donaldhbailie/reck-pcba/reck-pcba.pdf

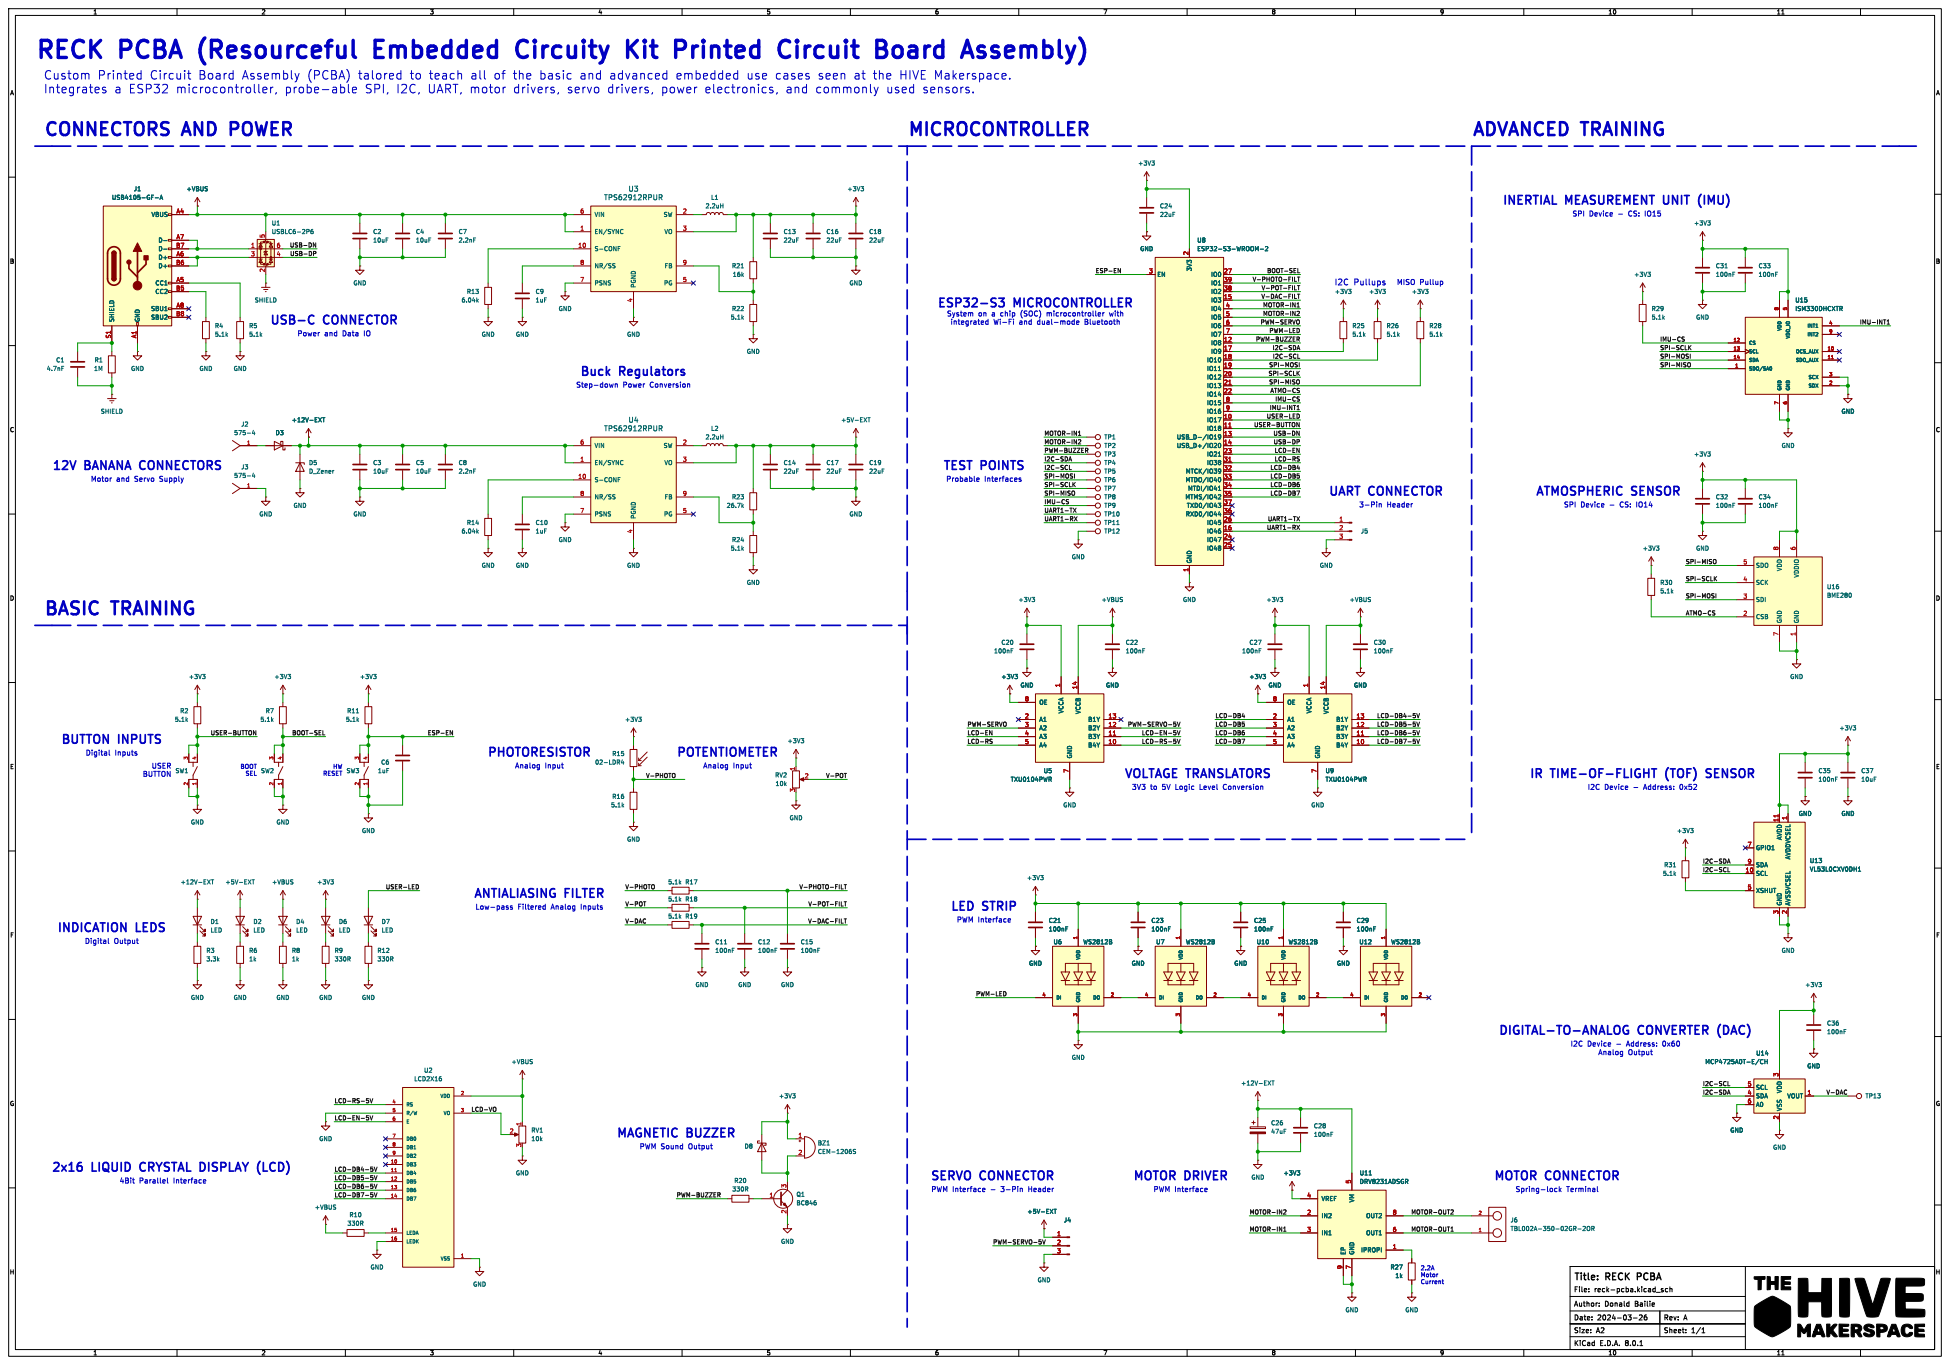
[picture p1: page 1]

Custom Printed Circuit Board Assembly (PCBA) talored to teach all of the basic and advanced embedded use cases seen at the HIVE Makerspace.
CONNECTORS AND POWER

4 VIN 6 EN/SYNC 1 S-CONF 10 SW 2 VO 3 PG 5 PSNS 7 NR/SS 8 FB 9 U3 TPS62912RPUR

INERTIAL MEASUREMENT UNIT (IMU)

MISO Pullup U8ESP32-S3-WROOM-2 GND

BOOT-SEL PWM-BUZZER
MOTOR-IN1 V-PHOTO-FILT PWM-SERVO
V-POT-FILT V-DAC-FILT PWM-LED

Power and Data IO

SPI-MOSI SPI-MISO
SPI-SCLK

4 VIN 6 EN/SYNC 1 S-CONF 10 SW 2 VO 3 PG 5 PSNS 7 NR/SS 8 FB 9 U4 TPS62912RPUR

I2C-SDA MOTOR-IN2 MOTOR-IN1 SPI-SCLK

Motor and Servo Supply

SPI-MISO
IMU-CS UART1-RX UART1-TX

7 OE 8 U5 TXU0104PWR GND GND GND

V-PHOTO
3V3 to 5V Logic Level Conversion PWM Sound Output

I2C Device - Address: 0x52 PWM Interface

3 DI 4 U6 WS2812B GND
PWM Interface SERVO CONNECTOR

I2C Device - Address: 0x60 DIGITAL-TO-ANALOG CONVERTER (DAC)

2x16 LIQUID CRYSTAL DISPLAY (LCD)
