donaldhbailie/reck-pcba/reck-pcba.kicad_pcb

## KiCad design reck-pcba.kicad_pcb (2024-08-18)

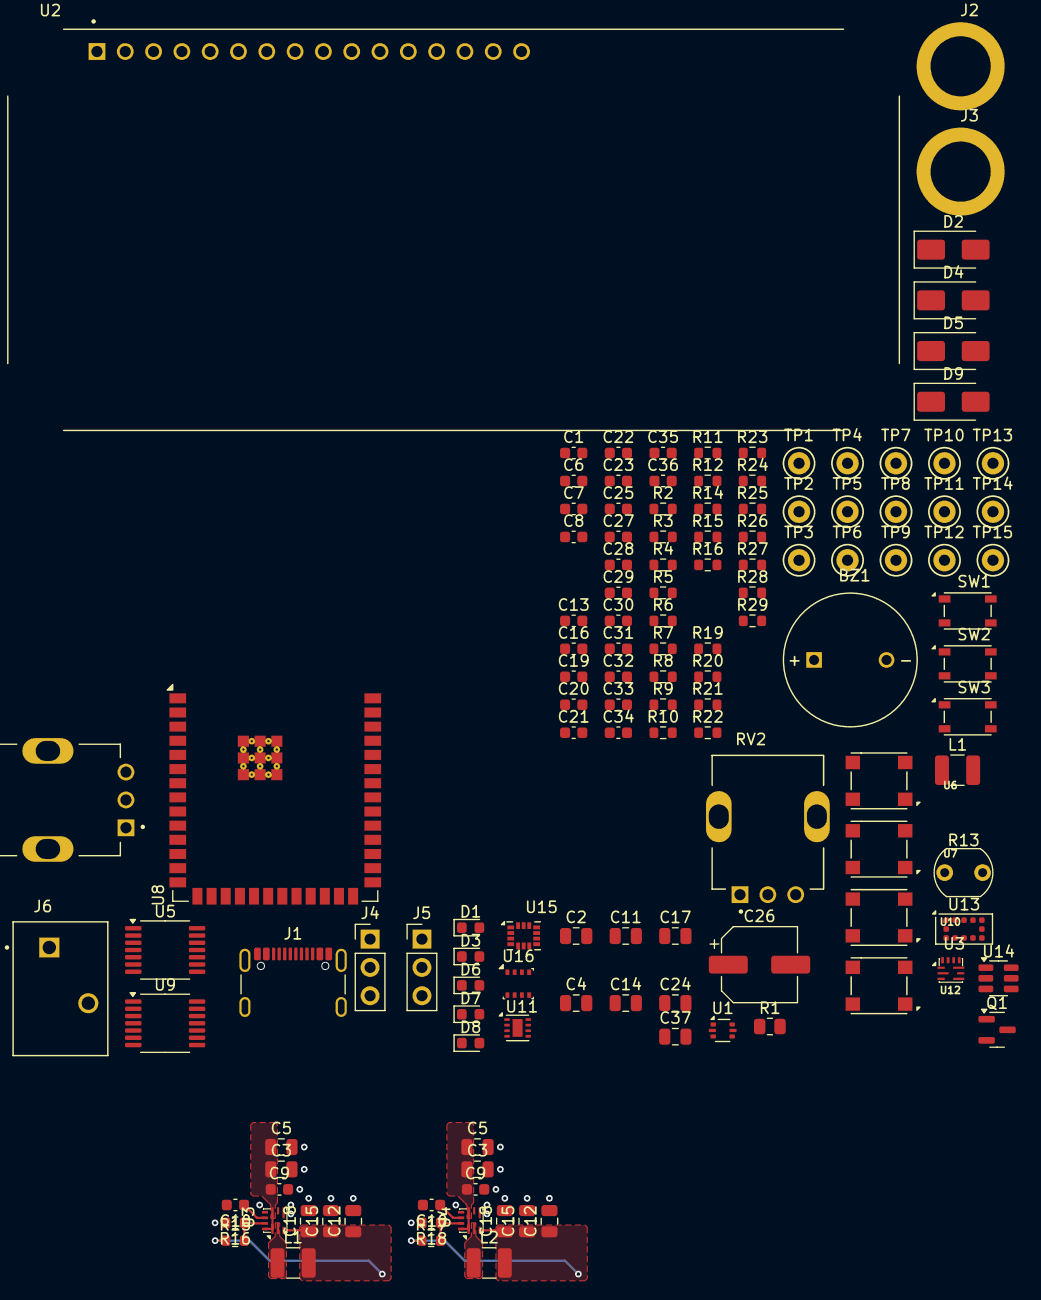
[picture p2: board reck-pcba.kicad_pcb from above]

Board: 4 copper layers, 132 parts (0 on the bottom side), 75 nets.

Parts:
BZ1: CEM-1206S
C1, C7, C9, C9#2: 2.2nF; C_0603_1608Metric
C2, C3, C3#2, C4, C5, C5#2, C37: 10uF; C_0805_2012Metric
C6, C8, C10, C10#2: 1uF; C_0603_1608Metric
C11, C12, C12#2, C14, C15, C15#2, C17, C18, C18#2, C24: 22uF; C_0805_2012Metric
C13, C16, C19, C20, C21, C22, C23, C25, C27, C28, C29, C30, C31, C32, C33, C34, C35, C36: 100nF; C_0603_1608Metric
C26: 47uF; CP_Elec_6.3x5.9
D1, D3, D6, D7, D8: LED; LED_0603_1608Metric
D2, D4, D9: CDBA340L-HF; D_SMA
D5: 1SMA5928BT3G; D_SMA
J1: USB4105-GF-A; USB_C_Receptacle_GCT_USB4105-xx-A_16P_TopMnt_Horizontal
J2, J3: 575-4
J4, J5: Conn_01x03_Pin; PinHeader_1x03_P2.54mm_Vertical
J6: TBL002A-350-02GR-2OR
L1, L1#2, L2: 2.2uH; L_1210_3225Metric
Q1: BC846; SOT-23
R1: 1M; R_0805_2012Metric
R2, R4, R5, R7, R11, R14, R16, R16#2, R18, R19, R20, R21, R23, R24, R26, R27, R28, R29: 5.1k; R_0603_1608Metric
R3, R25: 1k; R_0603_1608Metric
R6, R8: 330R; R_0603_1608Metric
R9, R10, R12, R22: 130R; R_0603_1608Metric
R13: 02-LDR4; R_LDR_5.1x4.3mm_P3.4mm_Vertical
R15: 16k; R_0603_1608Metric
R15#2, R17: 26.7k; R_0603_1608Metric
RV1, RV2: 10k; PT01-D130D-B103
SW1, SW2, SW3: PTS810_SJM_250_SMTR_LFS
TP1, TP2, TP3, TP4, TP5, TP6, TP7, TP8, TP9, TP10, TP11, TP12, TP13, TP14, TP15: TestPoint; TestPoint_Keystone_5000-5004_Miniature
U1: USBLC6-2P6; SOT-666
U2: LCD2X16
U3, U3#2, U4: TPS62912RPUR; VQFN-HR-10_2x2mm
U5, U9: TXU0104PWR; TSSOP-14_4.4x5mm_P0.65mm
U6, U7, U10, U12: WS2812B
U8: ESP32-S3-WROOM-2
U11: DRV8231ADSGR; WSON-8-1EP_2x2mm_P0.5mm_EP0.9x1.6mm
U13: VL53L0CXV0DH1; ST_VL53L1x
U14: MCP4725A0T-E/CH; SOT-23-6
U15: ISM330DHCXTR; LGA-14_2.5x3.0mm_P0.5mm
U16: BME280; Bosch_LGA-8_2.5x2.5mm_P0.65mm_ClockwisePinNumbering

Connections:
+3V3: BZ1.1, C11.1, C14.1, C17.1, C20.1, C21.1, C23.1, C24.1, C25.1, C27.1, C29.1, C31.1, C32.1, C33.1, C34.1, C35.1, C36.1, C37.1, D7.2 (A), D9.1 (K), L1.2, R2.1, R7.1, R11.1, R13.1, R15.1, R23.1, R24.1, R26.1, R27.1, R28.1, R29.1, RV2.1, U3#2.3 (VO), U5.1 (VCCA), U5.8 (OE), U6.1 (VDD), U7.1 (VDD), U8.2 (3V3), U9.1 (VCCA), U9.8 (OE), U10.1 (VDD), U11.4 (VREF), U12.1 (VDD), U13.1 (AVDDVCSEL), U13.11 (AVDD), U14.3 (VDD), U15.5 (VDD_IO), U15.8 (VDD), U16.6 (VDDIO), U16.8 (VDD)
+5V-EXT: C12.1, C12#2.1, C15.1, C15#2.1, C18.1, C18#2.1, D3.2 (A), J4.1, L1#2.2, L2.2, R15#2.1, R17.1, U3.3 (VO), U4.3 (VO)
+12V-EXT: C3.1, C3#2.1, C5.1, C5#2.1, C9.1, C9#2.1, C26.1, C28.1, D1.2 (A), D4.1 (K), D5.1 (K), U3.1 (EN/SYNC), U3.6 (VIN), U3.10 (S-CONF), U4.1 (EN/SYNC), U4.6 (VIN), U4.10 (S-CONF), U11.5 (VM)
+VBUS: C2.1, C4.1, C7.1, C22.1, C30.1, D2.1 (K), D6.2 (A), R10.1, RV1.1, U1.5 (VBUS), U2.2 (VDD), U3#2.1 (EN/SYNC), U3#2.6 (VIN), U3#2.10 (S-CONF), U5.14 (VCCB), U9.14 (VCCB)
+VBUS-CONN: D2.2 (A), J1.A4 (VBUS), J1.A9 (VBUS), J1.B4 (VBUS), J1.B9 (VBUS)
/ATMO-CS: R28.2, U8.22 (IO14), U16.2 (CSB)
/BOOT-SEL: R7.2, SW2.3, SW2.4, U8.27 (IO0)
/ESP-EN: C6.1, R11.2, SW3.3, SW3.4, U8.3 (EN)
/I2C-SCL: R24.2, TP5.1, U8.18 (IO10), U13.10 (SCL), U14.5 (SCL)
/I2C-SDA: R23.2, TP4.1, U8.17 (IO9), U13.9 (SDA), U14.4 (SDA)
/IMU-CS: R27.2, TP9.1, U8.8 (IO15), U15.12 (CS)
/IMU-INT1: U8.9 (IO16), U15.4 (INT1)
/LCD-DB4: U8.32 (MTCK/IO39), U9.2 (A1)
/LCD-DB4-5V: U2.11 (DB4), U9.13 (B1Y)
/LCD-DB5: U8.33 (MTDO/IO40), U9.3 (A2)
/LCD-DB5-5V: U2.12 (DB5), U9.12 (B2Y)
/LCD-DB6: U8.34 (MTDI/IO41), U9.4 (A3)
/LCD-DB6-5V: U2.13 (DB6), U9.11 (B3Y)
/LCD-DB7: U8.35 (MTMS/IO42), U9.5 (A4)
/LCD-DB7-5V: U2.14 (DB7), U9.10 (B4Y)
/LCD-EN: U5.4 (A3), U8.23 (IO21)
/LCD-EN-5V: U2.6 (E), U5.11 (B3Y)
/LCD-RS: U5.5 (A4), U8.31 (IO38)
/LCD-RS-5V: U2.4 (RS), U5.10 (B4Y)
/LCD-VO: RV1.2, U2.3 (VO)
/MOTOR-IN1: TP2.1, U8.4 (IO4), U11.3 (IN1)
/MOTOR-IN2: TP3.1, U8.5 (IO5), U11.2 (IN2)
/MOTOR-OUT1: J6.1, U11.6 (OUT1)
/MOTOR-OUT2: J6.2, U11.8 (OUT2)
/PWM-BUZZER: R22.1, U8.12 (IO8)
/PWM-LED: U6.4 (DI), U8.7 (IO7)
/PWM-SERVO: TP12.1, U5.3 (A2), U8.6 (IO6)
/PWM-SERVO-5V: J4.2, TP13.1, U5.12 (B2Y)
/SPI-MISO: R26.2, TP8.1, U8.21 (IO13), U15.1 (SDO/SA0), U16.5 (SDO)
/SPI-MOSI: TP6.1, U8.19 (IO11), U15.14 (SDA), U16.3 (SDI)
/SPI-SCLK: TP7.1, U8.20 (IO12), U15.13 (SCL), U16.4 (SCK)
/UART1-RX: J5.2, TP11.1, U8.16 (IO46)
/UART1-TX: J5.1, TP10.1, U8.26 (IO45)
/USB-DN: U1.6 (I/O1), U8.13 (USB_D-/IO19)
/USB-DP: U1.4 (I/O2), U8.14 (USB_D+/IO20)
/USER-BUTTON: R2.2, SW1.3, SW1.4, U8.11 (IO18)
/USER-LED: D8.2 (A), U8.10 (IO17)
/V-DAC: R21.2, TP1.1, U14.1 (VOUT)
/V-DAC-FILT: C13.1, R21.1, U8.15 (IO3)
/V-PHOTO: R13.2, R14.1, R19.2
/V-PHOTO-FILT: C19.1, R19.1, U8.39 (IO1)
/V-POT: R20.2, RV2.2
/V-POT-FILT: C16.1, R20.1, U8.38 (IO2)
GND: C2.2, C3.2, C3#2.2, C4.2, C5.2, C5#2.2, C6.2, C7.2, C8.2, C9.2, C9#2.2, C10.2, C10#2.2, C11.2, C12.2, C12#2.2, C13.2, C14.2, C15.2, C15#2.2, C16.2, C17.2, C18.2, C18#2.2, C19.2, C20.2, C21.2, C22.2, C23.2, C24.2, C25.2, C26.2, C27.2, C28.2, C29.2, C30.2, C31.2, C32.2, C33.2, C34.2, C35.2, C36.2, C37.2, D5.2 (A), J1.A1 (GND), J1.A12 (GND), J1.B1 (GND), J1.B12 (GND), J3.1, J4.3, J5.3, Q1.2 (E), R3.2, R4.2, R5.2, R6.2, R8.2, R9.2, R12.2, R14.2, R16.2, R16#2.2, R18.2, R25.2, RV1.3, RV2.3, SW1.1, SW1.2, SW2.1, SW2.2, SW3.1, SW3.2, TP14.1, TP15.1, U2.1 (VSS), U2.5 (R/W), U2.16 (LEDK), U3.4 (PGND), U3.7 (PSNS), U3#2.4 (PGND), U3#2.7 (PSNS), U4.4 (PGND), U4.7 (PSNS), U5.7 (GND), U6.3 (GND), U7.3 (GND), U8.1 (GND), U8.40 (GND), U8.41 (GND), U9.7 (GND), U10.3 (GND), U11.7 (GND), U11.9 (EP), U12.3 (GND), U13.2 (AVSSVCSEL), U13.3 (GND), U13.4 (GND), U13.6 (GND), U13.12 (GND), U14.2 (VSS), U14.6 (A0), U15.2 (SDX), U15.3 (SCX), U15.6 (GND), U15.7 (GND), U16.1 (GND), U16.7 (GND)
unnamed: D1.1 (K), R3.1
unnamed: D3.1 (K), R6.1
unnamed: D4.2 (A), J2.1
unnamed: D6.1 (K), R8.1
unnamed: D7.1 (K), R9.1
unnamed: D8.1 (K), R12.1
unnamed: BZ1.2, D9.2 (A), Q1.3 (C)
unnamed: J1.A5 (CC1), R5.1
unnamed: J1.B5 (CC2), R4.1
unnamed: J1.A6 (D+), J1.B6 (D+), U1.3 (I/O2)
unnamed: J1.A7 (D-), J1.B7 (D-), U1.1 (I/O1)
unnamed: C1.1, J1.S1 (SHIELD), R1.1
unnamed: Q1.1 (B), R22.2
unnamed: R10.2, U2.15 (LEDA)
unnamed: R15.2, R16.1, U3#2.9 (FB)
unnamed: C8.1, U3#2.8 (NR/SS)
unnamed: L1.1, U3#2.2 (SW)
unnamed: R15#2.2, R16#2.1, R17.2, R18.1, U3.9 (FB), U4.9 (FB)
unnamed: C10.1, C10#2.1, U3.8 (NR/SS), U4.8 (NR/SS)
unnamed: L1#2.1, L2.1, U3.2 (SW), U4.2 (SW)
unnamed: U6.2 (DO), U7.4 (DI)
unnamed: U7.2 (DO), U10.4 (DI)
unnamed: U10.2 (DO), U12.4 (DI)
unnamed: R25.1, U11.1 (IPROPI)
unnamed: R29.2, U13.5 (XSHUT)
SHIELD: C1.2, R1.2, U1.2 (GND)
