donaldhbailie/reck-pcba/(commit log)

2024-02-29 Intial Project files
    [reck-pcba.kicad_pcb, reck-pcba.kicad_sch]
2024-03-06 Added ESP32, Power, LEDs, IMU, and GPS - Added supporting libraries - Added datasheets in the doc/datasheet folder
    [reck-pcba.kicad_pcb, reck-pcba.kicad_sch]
2024-03-15 Added new uC, Power, and Motor support - Updated ESP32-C3 to ESP32-S3 due to GPIO constraints - Using two buck regulators for servo 5V power and board 3V3
    [power.kicad_sch, reck-pcba.kicad_pcb, reck-pcba.kicad_sch]
2024-03-27 Full Schematics Complete - Changed uC to ESP32-S3-WROOM-2 to allow for pinout discussion. - Moved buck regulators to main sheet. - Added titles and descriptions to each Sensor, Interface, or concept.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
    [power.kicad_sch, reck-pcba.kicad_pcb, reck-pcba.kicad_sch]
2024-03-27 Updated IR TOF Sensor Wording - Changed "IR LASER TOF SENSOR" to "IR TIME-OF-FLIGHT (TOF) SENSOR". - Updated Schematic. - Updated PDF.
    [reck-pcba.kicad_sch]
2024-03-27 Update README.md
    - Added Schematic Preview.
